janpfrang/Ali-s-ISOBUS-motorcontrol/README.md

# Ali-s-ISOBUS-motorcontrol
ESP32 / SN65HVD230 motor controll via ISOBUS for a seeder
