janpfrang/Ali-s-ISOBUS-motorcontrol/docs_requirements/Schematic_20260407.pdf

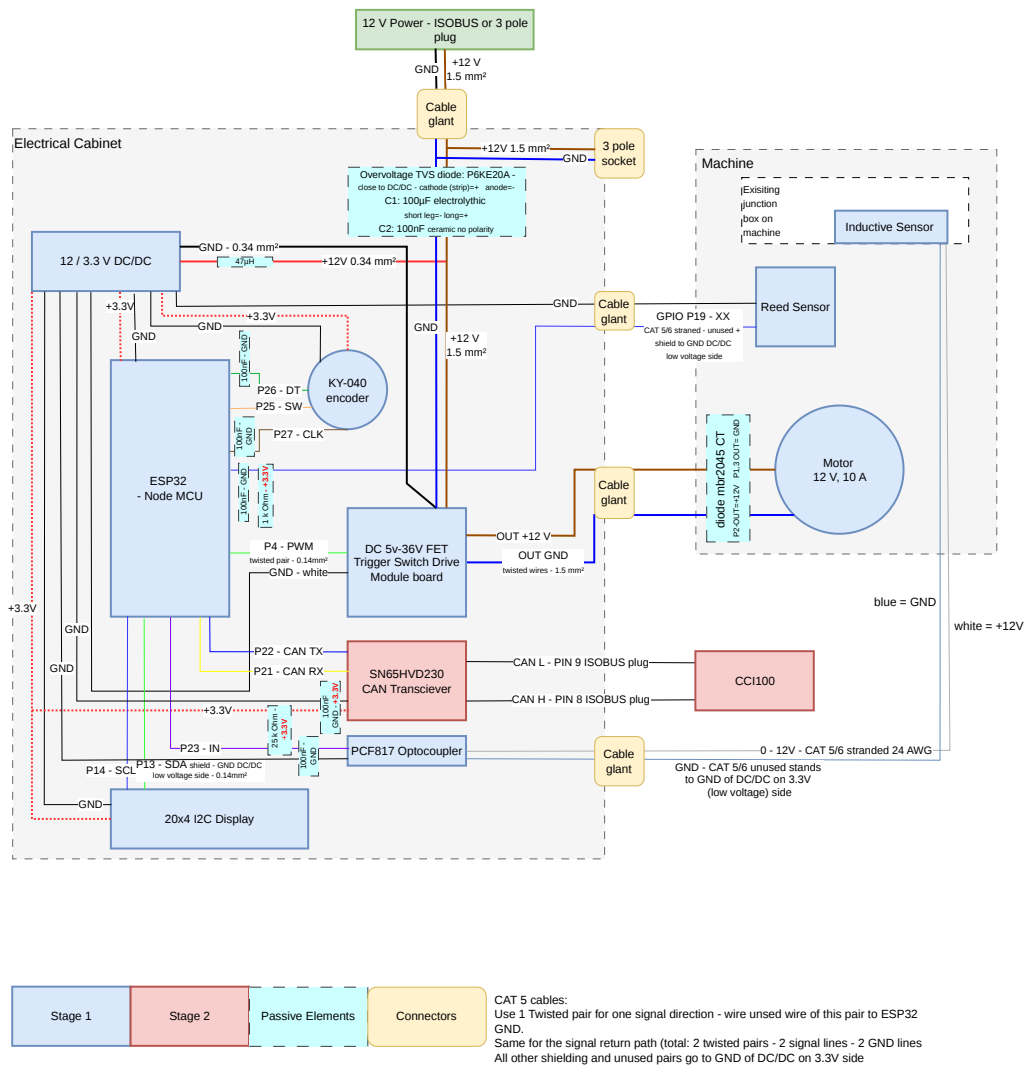
[picture p1: page 1]

12 V Power - ISOBUS or 3 pole

Overvoltage TVS diode: P6KE20A -
close to DC/DC - cathode (strip)=+ anode=-
C1: 100µF electrolythic
short leg=- long=+
C2: 100nF ceramic no polarity

GPIO P19 - XX
CAT 5/6 straned - unused +
shield to GND DC/DC
low voltage side

CAN L - PIN 9 ISOBUS plug

CAN H - PIN 8 ISOBUS plug

P13 - SDA shield - GND DC/DC
low voltage side - 0.14mm²

GND - CAT 5/6 unused stands
to GND of DC/DC on 3.3V
(low voltage) side

CAT 5 cables:
Use 1 Twisted pair for one signal direction - wire unsed wire of this pair to ESP32
GND.
Same for the signal return path (total: 2 twisted pairs - 2 signal lines - 2 GND lines
All other shielding and unused pairs go to GND of DC/DC on 3.3V side
