janpfrang/Ali-s-ISOBUS-motorcontrol/(commit log)

2026-02-22 schematic for stage 1 - no ISOBUS active yet
    Schematic contains some EMC and anti disturbance measures
2026-02-22 Add stage 1 bring-up code for motor controller
    Initial implementation of Ali's Motor Controller with rotary encoder and LCD display support and reed switch for speed controls.
2026-02-22 Revise ISOBUS Motor Control Requirements to version 1.0
    Updated requirements specification for ISOBUS motor control system, including versioning, project overview, functional requirements, and testing strategy. Expanded details on stages of development and clarified user interface requirements.
2026-02-23 el cabinet layout.drawio eingefügt
2026-02-24 Modify circuit diagram dimensions and positions
    Updated the dimensions and positions of various components in the circuit diagram.
2026-02-24 Add circuit diagram for February 24, 2026
2026-02-25 Update print statement to say 'Goodbye World'
2026-02-25 circuit_20260225.drawio aktualisiert
2026-02-25 Add circuit diagram for 20260225
2026-02-25 Update circuit diagram dimensions and connections
2026-02-26 circuit_20260225.drawio pins aktualisiert
2026-02-26 Add circuit diagram for 20260226 pins updated
2026-02-26 Update connection value in circuit diagram pin 23 instead of 33
2026-02-26 Update hardware pin definitions for stage 1
2026-03-03 schematic_03032026.drawio eingefügt
2026-03-05 pins pwm updated, cable colors aupdated
2026-03-05 schematic_05032026.drawio eingefügt
2026-04-07 Schematic_20260407.drawio eingefügt
2026-04-07 Schematic_20260407.pdf eingefügt
2026-04-07 Refactor pin assignments and enhance sensor handling
    Updated pin assignments and added inductive sensor functionality. Improved button handling and display updates.
2026-04-07 Update ISOBUS Motor Control Requirements to version 1.1
2026-04-07 Add Canable firmware detection script
    This script detects the firmware of a Canable device by scanning for serial ports and providing instructions based on the detected ports.
2026-04-08 Stage 2.2 Firmware for ESP32 - speed simulator
    via isobus
2026-04-12 Add ISOBUS Address Claim implementation for ESP32
    Phase 2.3 works! The ESP32 successfully claimed address 0x80 (128) and the PC received and decoded the NAME correctly:
    Industry group: 2 (Agriculture) ✅
    Device class: 25 (Implement) ✅
    Function: 130 (Planter/Seeder) ✅
    Self-configurable: 1 ✅
    Identity: 1 (prototype) ✅
    What does the ESP32 Serial Monitor show? You should see:
    *** ADDRESS CLAIMED: 0x80 (128) ***
    And after a few seconds, speed messages should also appear since the verifier is sending 8.0 km/h.
    Now if you want to test the conflict resolution, stop the script (Ctrl+C), replug the Canable, and run:
    python isobus_address_claim_verify.py --request --conflict
    This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
    [isobus_address_claim.ino]
2026-04-12 Rename stage 1 bring up code to stage 1 bring up code,ino
2026-04-12 Rename stage 1 bring up code,ino to stage 1 bring up code.ino
2026-04-12 Refactor inductive speed sensor logic and debounce
    Updated the inductive speed sensor handling and improved debounce logic. Added null-guard and real edge timestamp storage for better accuracy.
2026-04-27 Create built.yml
    built pipline to compile in a container
    Das fertige .bin flashen
    Das Build-Artifact (.bin) lädst du dir herunter und flasht es mit esptool.py direkt — keine IDE nötig:
    bashesptool.py --chip esp32 --port /dev/ttyUSB0 write_flash 0x1000 firmware.bin
    Oder du nutzt den Arduino CLI lokal nur noch zum Flashen, nicht mehr zum Kompilieren.
2026-04-27 Rename stage 1 bring up code.ino to stage_1_bring_up_code.ino
2026-04-27 Update built.yml
    library wanring i2c AVR only surpressed, esp32 core 3.x added
